ahmadtak-3212/nikolai_project/archive/Server/README.md

# This is the folder for all server related code\
## Server.py
- Main Driver of the server handles databease and web ui requests
