ahmadtak-3212/nikolai_project/mechanical/cad/Parts/Hand/Hand_Reference_Top.jpg

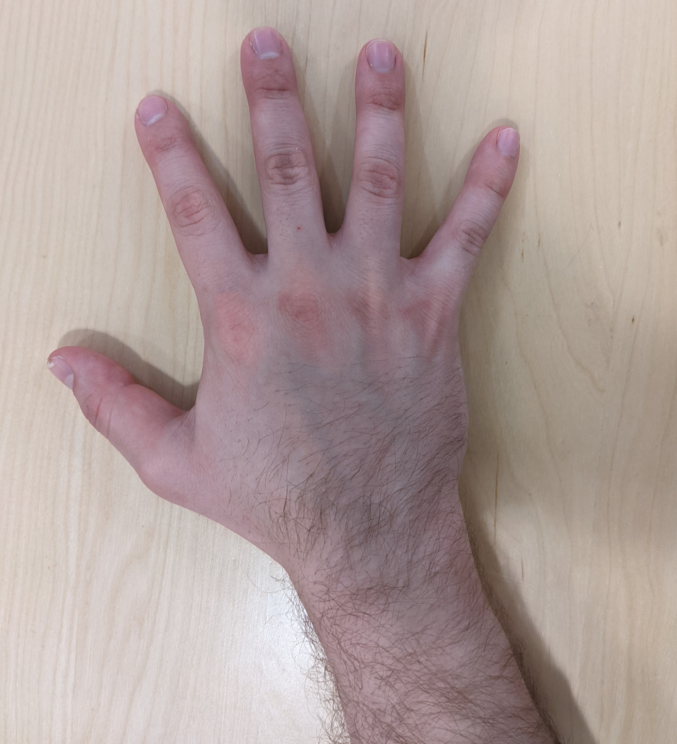
mechanical/cad/Parts/Hand/Hand_Reference_Top.jpg
