ahmadtak-3212/nikolai_project/mechanical/cad/Nikolai.SLDASM

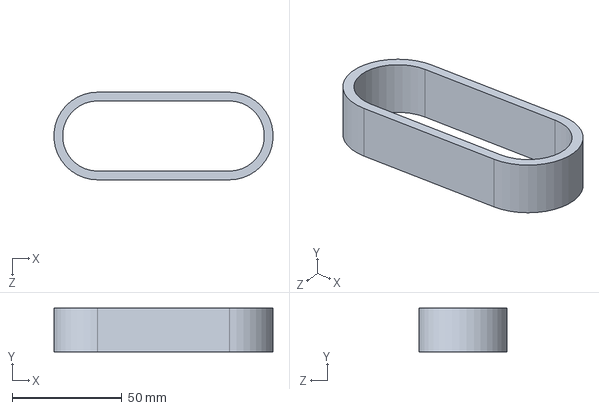
[picture p11: CAD file, 2022-06-26]
mechanical/cad/Nikolai.SLDASM
99.9 x 20.0 x 40.0 mm
