ahmadtak-3212/nikolai_project/mechanical/cad/Parts/Coil/Coil.SLDASM

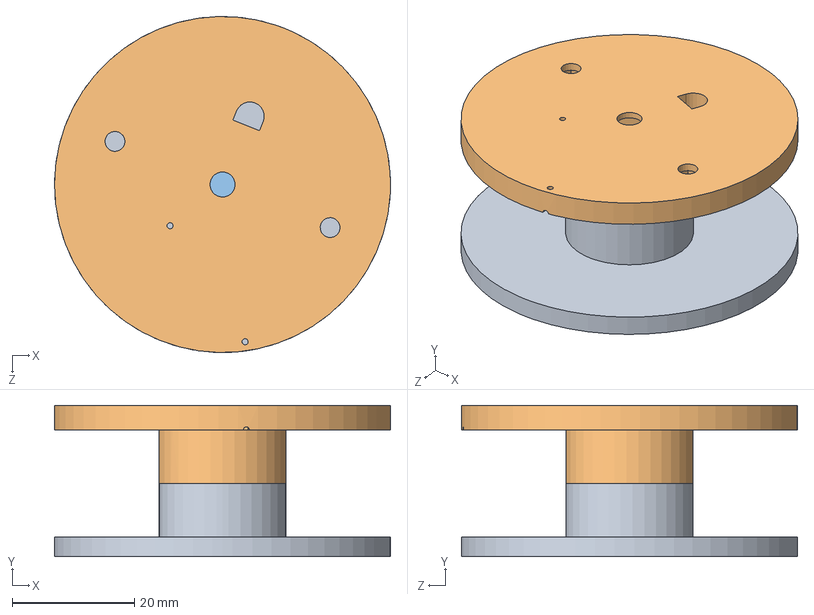
[picture p12: CAD file, 2022-06-26]
mechanical/cad/Parts/Coil/Coil.SLDASM
55.0 x 24.8 x 55.0 mm
Coil_Male
Coil_Female
