ahmadtak-3212/nikolai_project/mechanical/cad/Parts/Hand/Hand.SLDASM

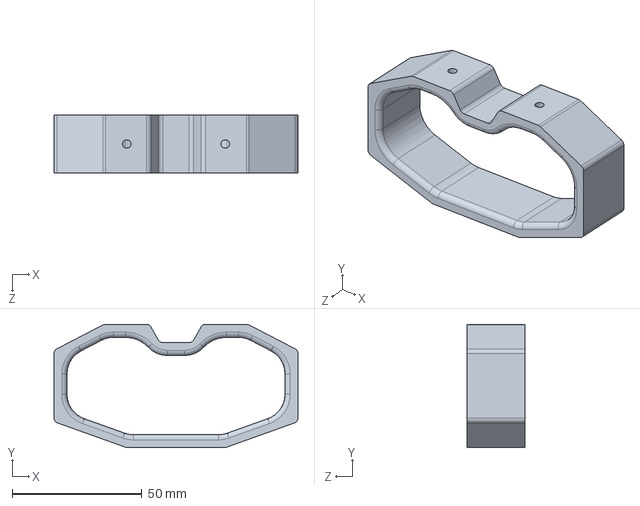
[picture p13: CAD file, 2022-06-26]
mechanical/cad/Parts/Hand/Hand.SLDASM
94.0 x 47.5 x 22.5 mm
