ahmadtak-3212/nikolai_project/mechanical/cad/Parts/Forearm/wrist_pcb.SLDASM

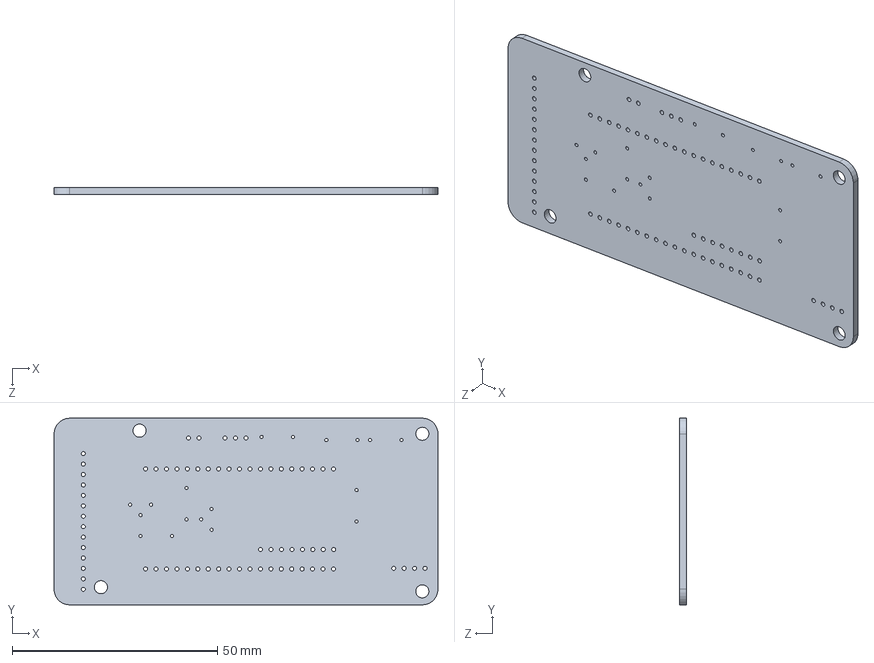
[picture p14: CAD file, 2022-06-26]
mechanical/cad/Parts/Forearm/wrist_pcb.SLDASM
93.5 x 45.5 x 1.60 mm
