ahmadtak-3212/nikolai_project/mechanical/cad/Parts/Coil/Coil_mount.SLDPRT

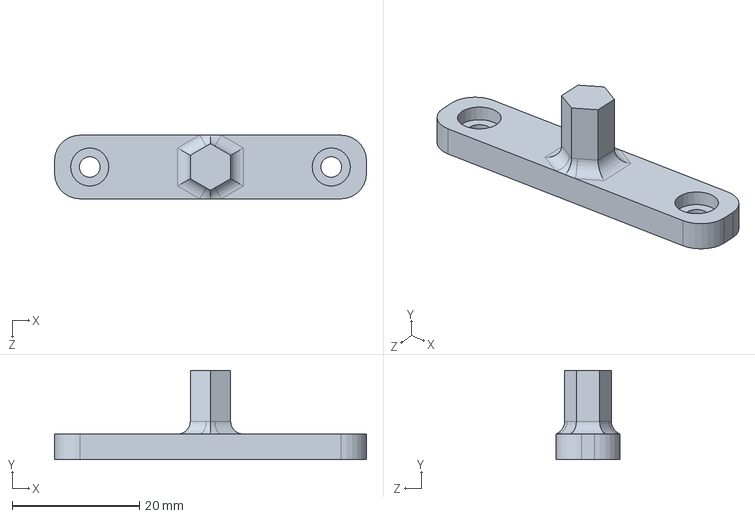
[picture p15: CAD file, 2022-06-26]
mechanical/cad/Parts/Coil/Coil_mount.SLDPRT
49.0 x 14.0 x 10.0 mm
