ahmadtak-3212/nikolai_project/mechanical/cad/Parts/Forearm/Top_Forearm.SLDPRT

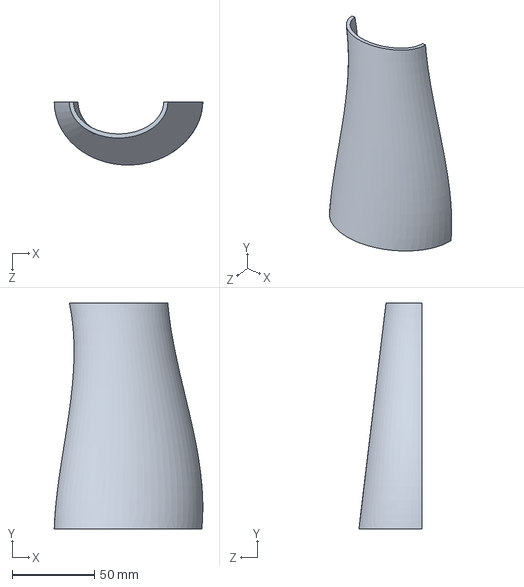
[picture p16: CAD file, 2022-06-26]
mechanical/cad/Parts/Forearm/Top_Forearm.SLDPRT
90.6 x 137.7 x 38.5 mm
