ahmadtak-3212/nikolai_project/mechanical/cam/UMS3_Forearm.3mf

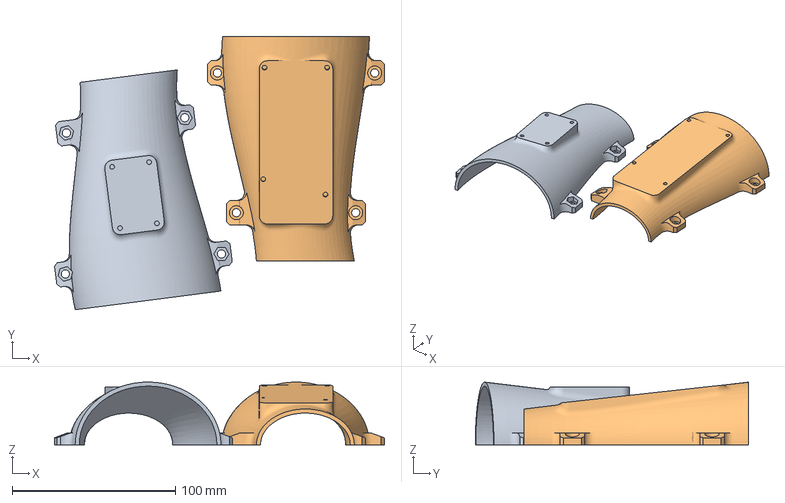
[picture p17: CAD file, 2022-06-26]
mechanical/cam/UMS3_Forearm.3mf
202.1 x 167.5 x 38.5 mm
Bottom_Cover.STL
Top_Cover.STL
