ahmadtak-3212/nikolai_project/mechanical/exports/stl/Coil/Coil - Coil_Female-1.STL

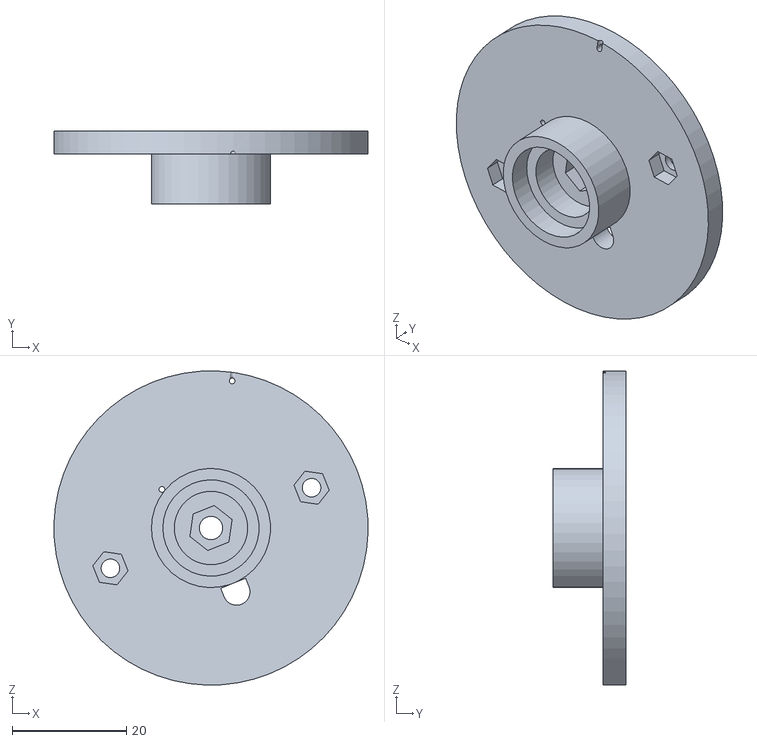
[picture p18: CAD file, 2022-06-26]
mechanical/exports/stl/Coil/Coil - Coil_Female-1.STL
55.0 x 12.8 x 55.0
