ahmadtak-3212/nikolai_project/mechanical/exports/stl/Hand/Hand  - Hand_Mount-1.STL

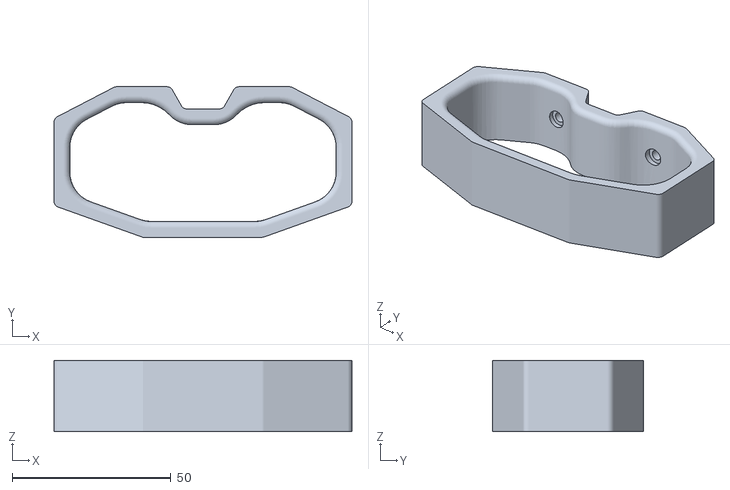
[picture p19: CAD file, 2022-06-26]
mechanical/exports/stl/Hand/Hand - Hand_Mount-1.STL
94.0 x 47.5 x 22.5
