ahmadtak-3212/nikolai_project/mechanical/cad/Parts/Forearm/Bottom_Cover.SLDPRT

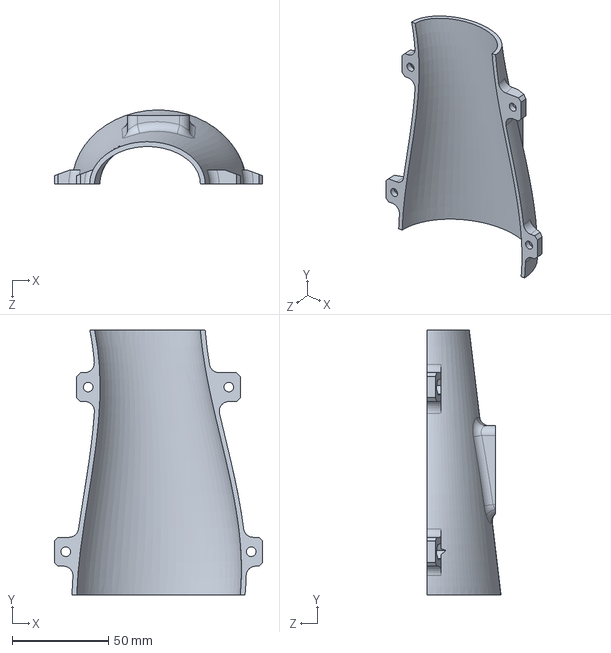
[picture p20: CAD file, 2022-06-26]
mechanical/cad/Parts/Forearm/Bottom_Cover.SLDPRT
108.4 x 137.7 x 38.5 mm
