ahmadtak-3212/nikolai_project/mechanical/exports/stl/Coil/Coil - Coil_Male-1.STL

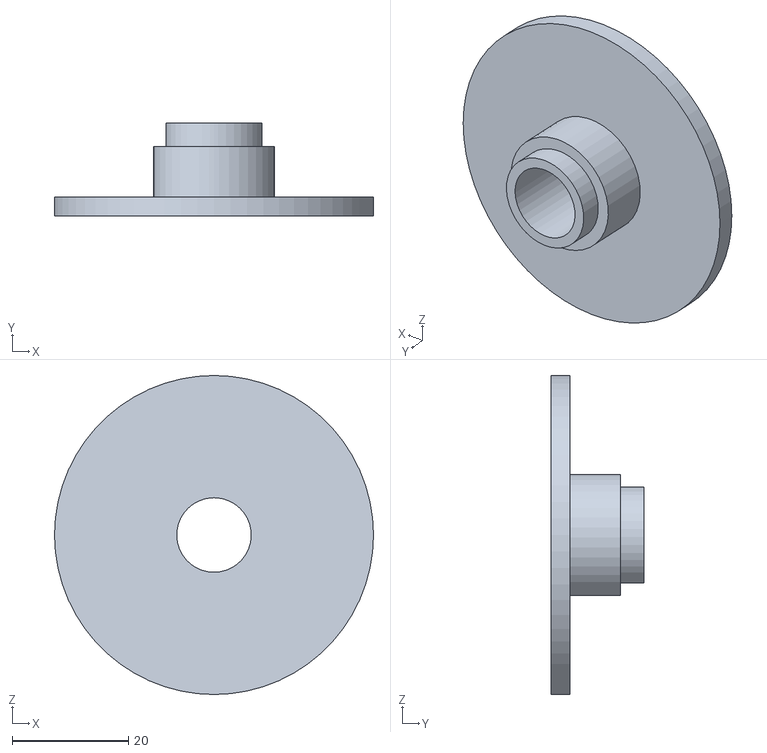
[picture p21: CAD file, 2022-06-26]
mechanical/exports/stl/Coil/Coil - Coil_Male-1.STL
55.0 x 16.0 x 55.0
