ahmadtak-3212/nikolai_project/mechanical/cad/Parts/Forearm/Forearm_Reference.SLDPRT

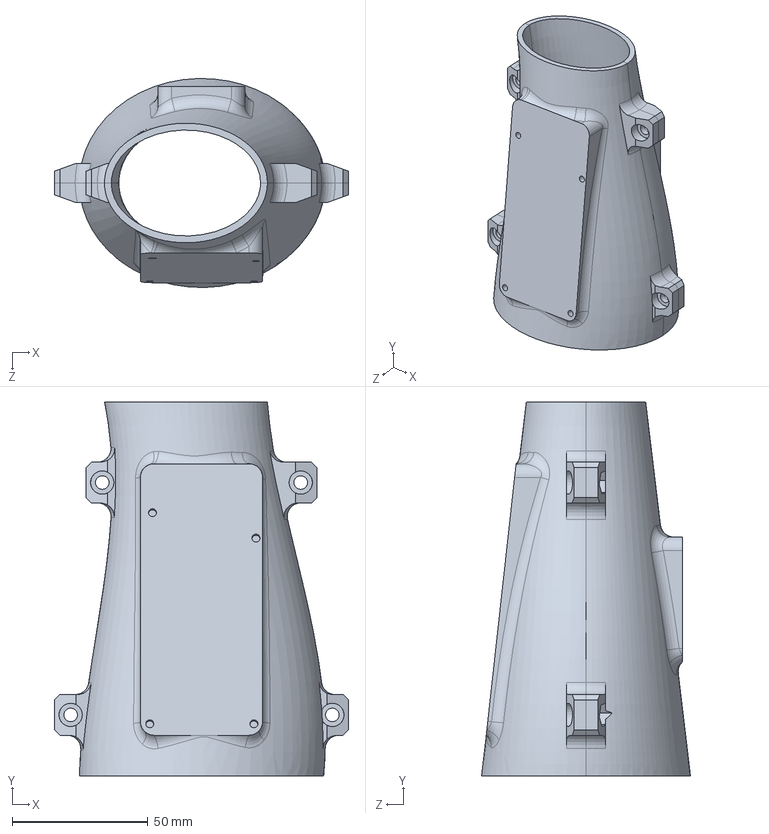
[picture p22: CAD file, 2022-06-26]
mechanical/cad/Parts/Forearm/Forearm_Reference.SLDPRT
108.4 x 137.7 x 77.0 mm
