ahmadtak-3212/nikolai_project/mechanical/cad/Parts/Hand/Hand_Mount.SLDPRT

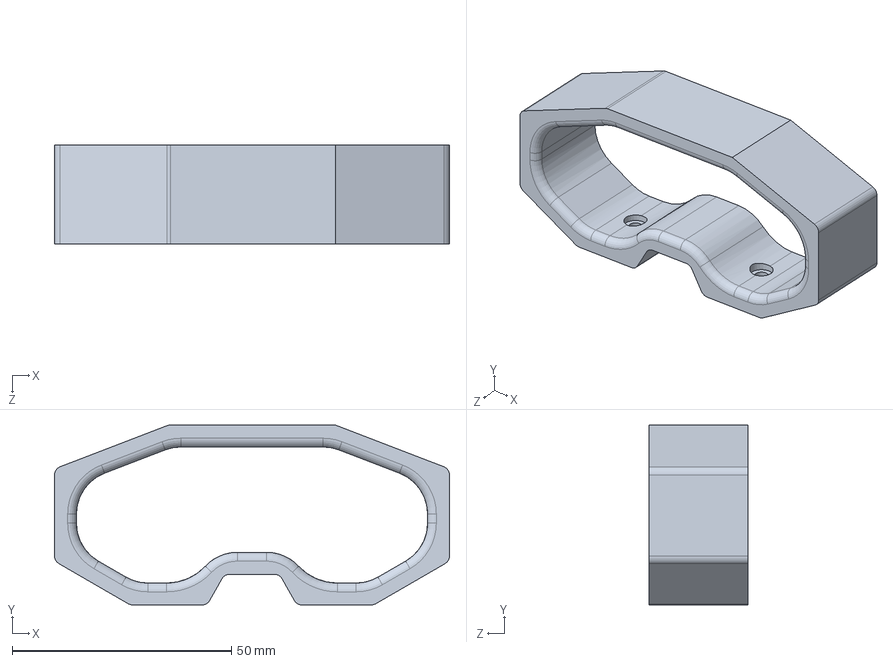
[picture p23: CAD file, 2022-06-26]
mechanical/cad/Parts/Hand/Hand_Mount.SLDPRT
90.0 x 41.0 x 22.5 mm
