ahmadtak-3212/nikolai_project/mechanical/cam/UMS3_Coil.3mf

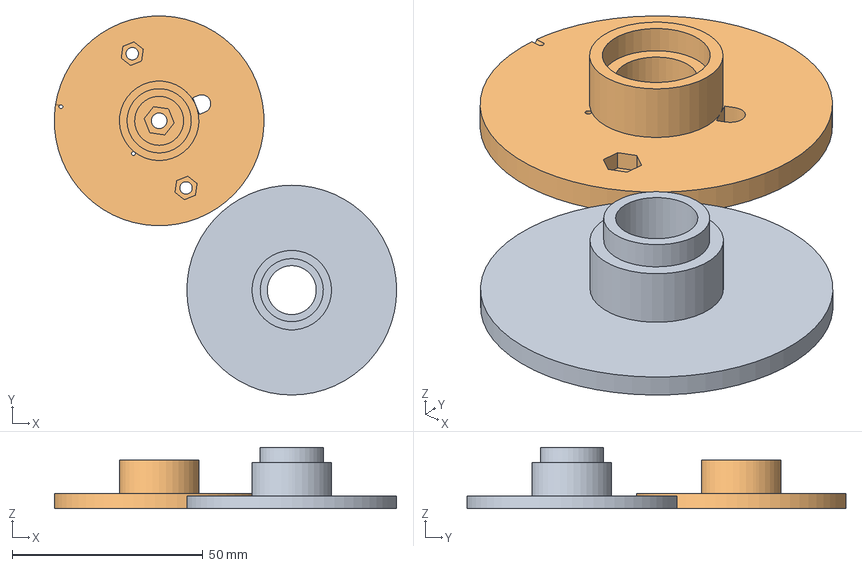
[picture p24: CAD file, 2022-06-26]
mechanical/cam/UMS3_Coil.3mf
89.8 x 99.4 x 16.0 mm
Coil - Coil_Male-1.STL
Coil - Coil_Female-1.STL
