ahmadtak-3212/nikolai_project/mechanical/cad/Parts/Coil/Coil_Winding.SLDPRT

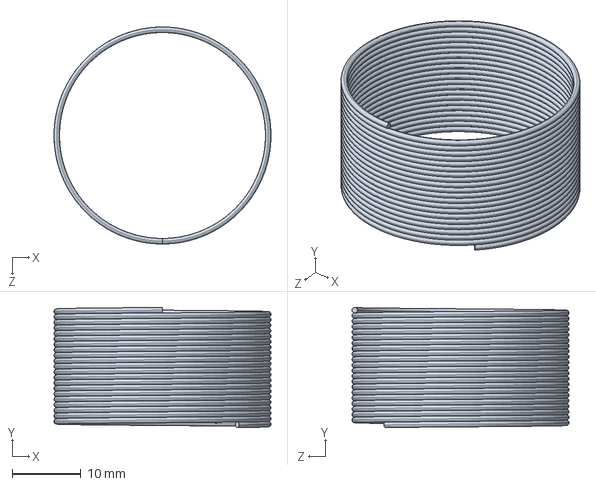
[picture p25: CAD file, 2022-06-26]
mechanical/cad/Parts/Coil/Coil_Winding.SLDPRT
31.6 x 17.5 x 31.6 mm
