ahmadtak-3212/nikolai_project/mechanical/cad/Parts/Coil/Coil_Male.SLDPRT

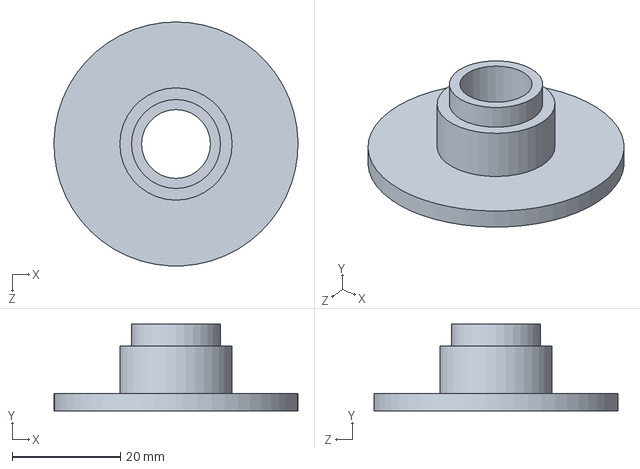
[picture p26: CAD file, 2022-06-26]
mechanical/cad/Parts/Coil/Coil_Male.SLDPRT
45.0 x 16.0 x 45.0 mm
