ahmadtak-3212/nikolai_project/mechanical/cad/Parts/Coil/Core.SLDPRT

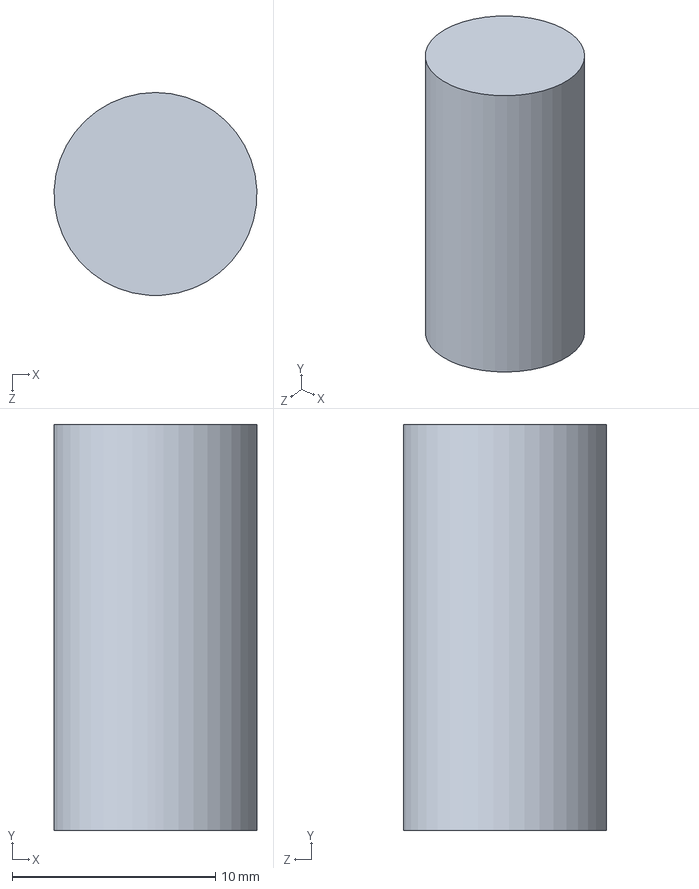
[picture p27: CAD file, 2022-06-26]
mechanical/cad/Parts/Coil/Core.SLDPRT
9.99 x 20.0 x 10.0 mm
