ahmadtak-3212/nikolai_project/(list of files, cad)

Other CAD files:
electrical/wrist_pcb_v1/wrist_pcb.step
mechanical/cad/Parts/Hand/Hand_Reference.SLDPRT
mechanical/exports/stl/Coil_mount.STL
mechanical/cam/UMS3_Hand.3mf
mechanical/cad/Parts/Coil/Coil_Female.SLDPRT
mechanical/cad/Parts/Forearm/Bottom_Forearm.SLDPRT
mechanical/cad/Parts/Forearm/Top_Cover.SLDPRT
mechanical/exports/stl/Forearm/Bottom_Cover.STL
mechanical/exports/stl/Forearm/Top_Cover.STL
