ahmadtak-3212/nikolai_project/electrical/coil_driver_v1/todo.txt

make min spacing 33 mil so it can mill faster. 
mounting holes.
