ahmadtak-3212/nikolai_project/electrical/Nikolai_Schematic.pdf

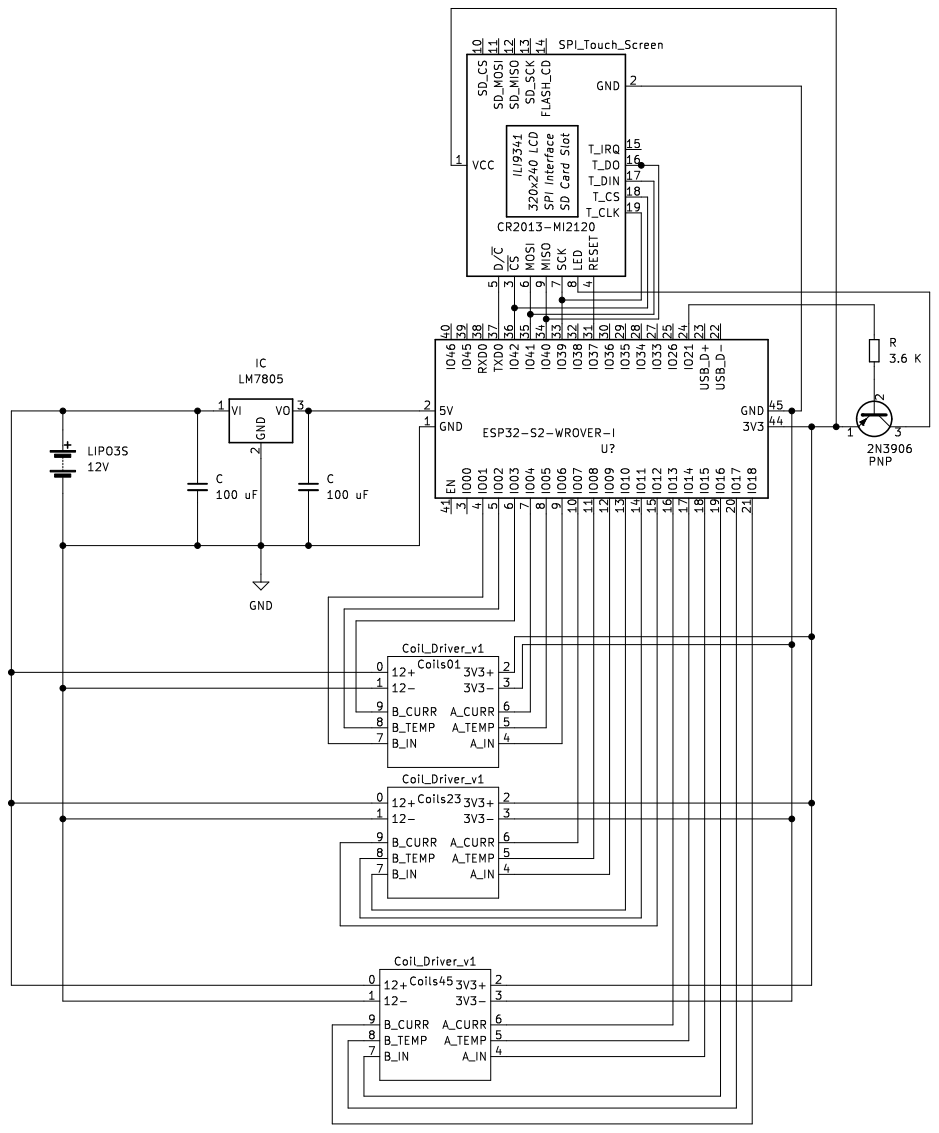
[picture p28: page 1]
