ahmadtak-3212/nikolai_project/electrical/Coil_Driver.pdf

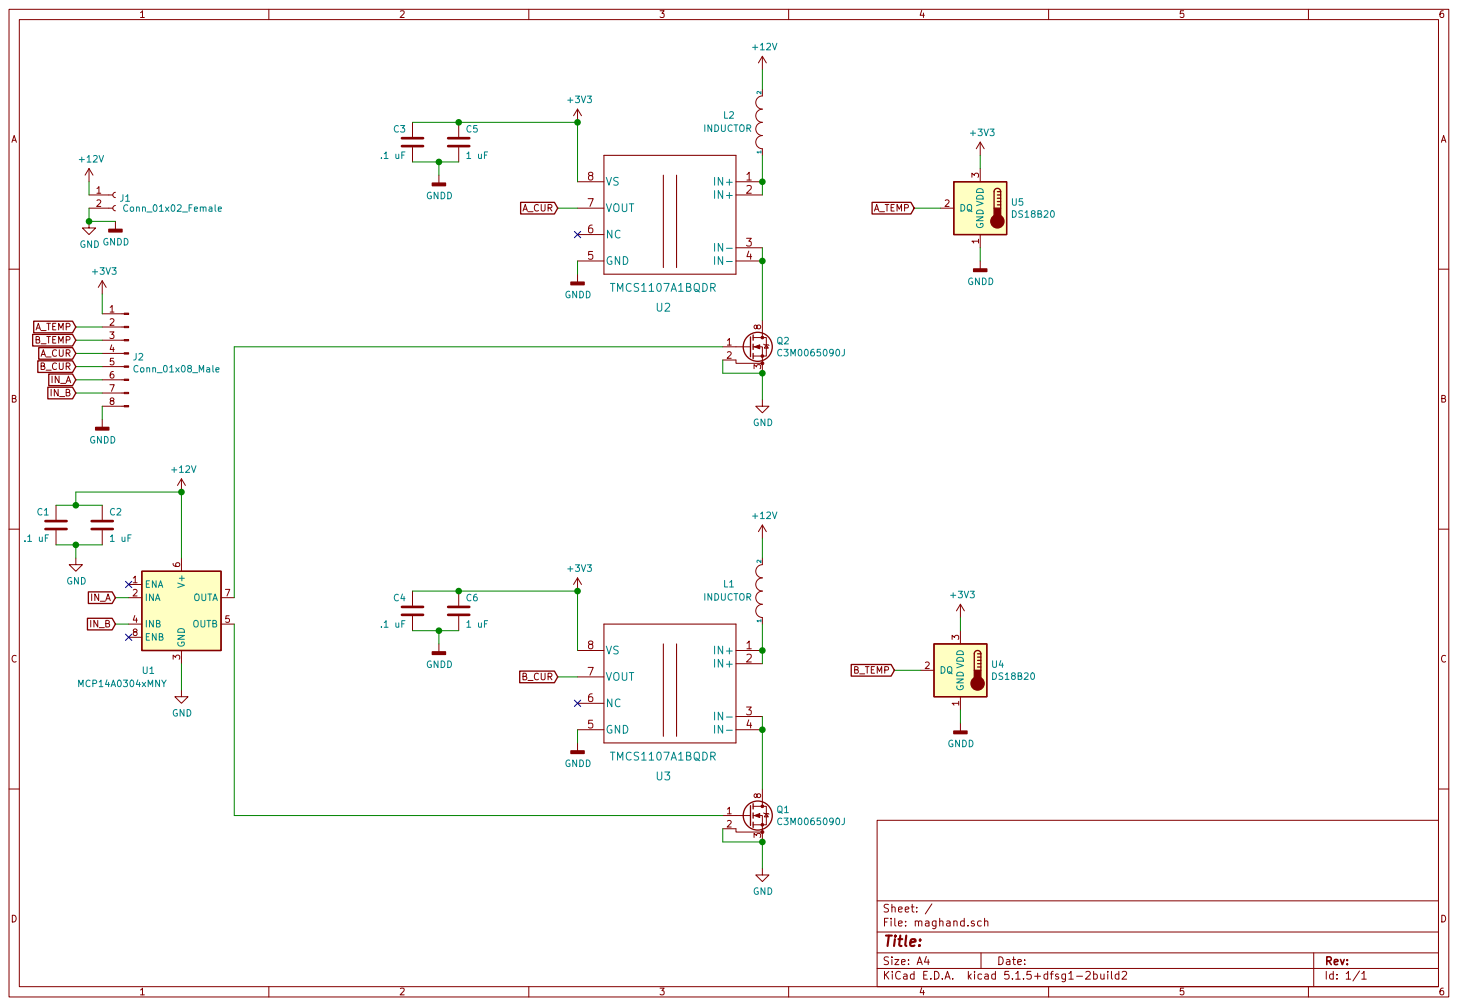
[picture p29: page 1]

File: maghand.sch Sheet: /
