ahmadtak-3212/nikolai_project/electrical/coil_driver_v1/maghand.kicad_pcb

## KiCad design electrical/coil_driver_v1/maghand.kicad_pcb (2026-09-30, an earlier design)

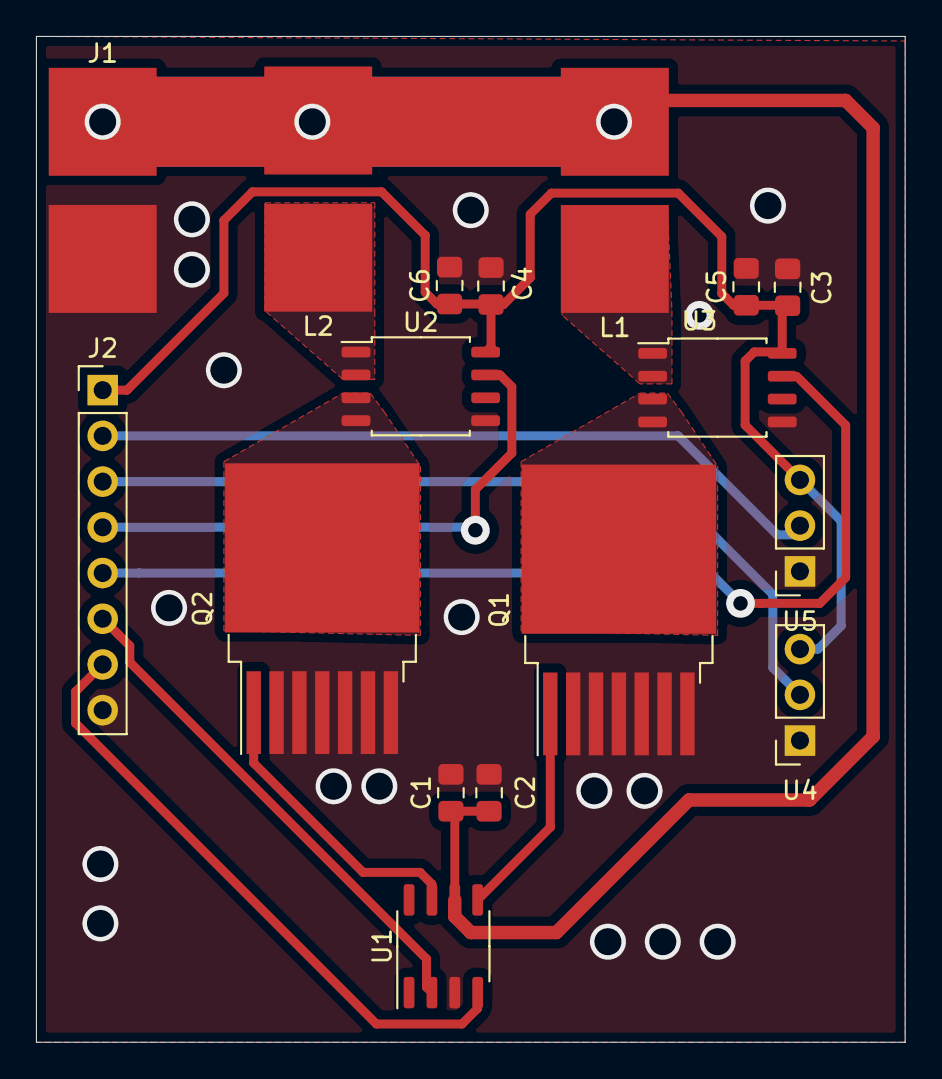
[picture p30: board electrical/coil_driver_v1/maghand.kicad_pcb from above]

Board: 2 copper layers, 48.3 x 55.9 mm, 17 parts (0 on the bottom side), 15 nets.

Parts:
C1, C3, C4: .1 uF; C_0805_2012Metric_Pad1.15x1.40mm_HandSolder
C2, C5, C6: 1 uF; C_0805_2012Metric_Pad1.15x1.40mm_HandSolder
J1: Conn_01x02_Female; 2x6mmsquare
J2: Conn_01x08_Male; PinHeader_1x08_P2.54mm_Vertical
L1, L2: INDUCTOR; 2x6mmsquare
Q1, Q2: C3M0065090J; TO-263-7_TabPin8
U1: MCP14A0304xMNY; SO-8_3.9x4.9mm_P1.27mm
U2, U3: TMCS1107A1BQDR; SOIC-8_5.23x5.23mm_P1.27mm
U4, U5: DS18B20; PinSocket_1x03_P2.54mm_Vertical

Connections:
+3V3: C3.1, C4.1, C5.1, C6.1, J2.1, U2.8, U3.8, U4.3, U5.3
+12V: C1.1, C2.1, J1.1, L1.2, L2.2, U1.6
A_CUR: J2.4, U2.7
A_TEMP: J2.2, U5.2
B_CUR: J2.5, U3.7
B_TEMP: J2.3, U4.2
GND: C1.2, C2.2, C3.2, C4.2, C5.2, C6.2, J1.2, J2.8, Q1.2, Q1.3, Q1.4, Q1.5, Q1.6, Q1.7, Q2.2, Q2.3, Q2.4, Q2.5, Q2.6, Q2.7, U1.3, U2.5, U3.5, U4.1, U5.1
IN_A: J2.6, U1.2
IN_B: J2.7, U1.4
unnamed: L1.1, U3.1, U3.2
unnamed: L2.1, U2.1, U2.2
unnamed: Q1.1, U1.5
unnamed: Q1.8, U3.3, U3.4
unnamed: Q2.1, U1.7
unnamed: Q2.8, U2.3, U2.4
