ahmadtak-3212/nikolai_project/electrical/wrist_pcb_v1/wrist_pcb.kicad_pcb

## KiCad design electrical/wrist_pcb_v1/wrist_pcb.kicad_pcb (2026-09-30)

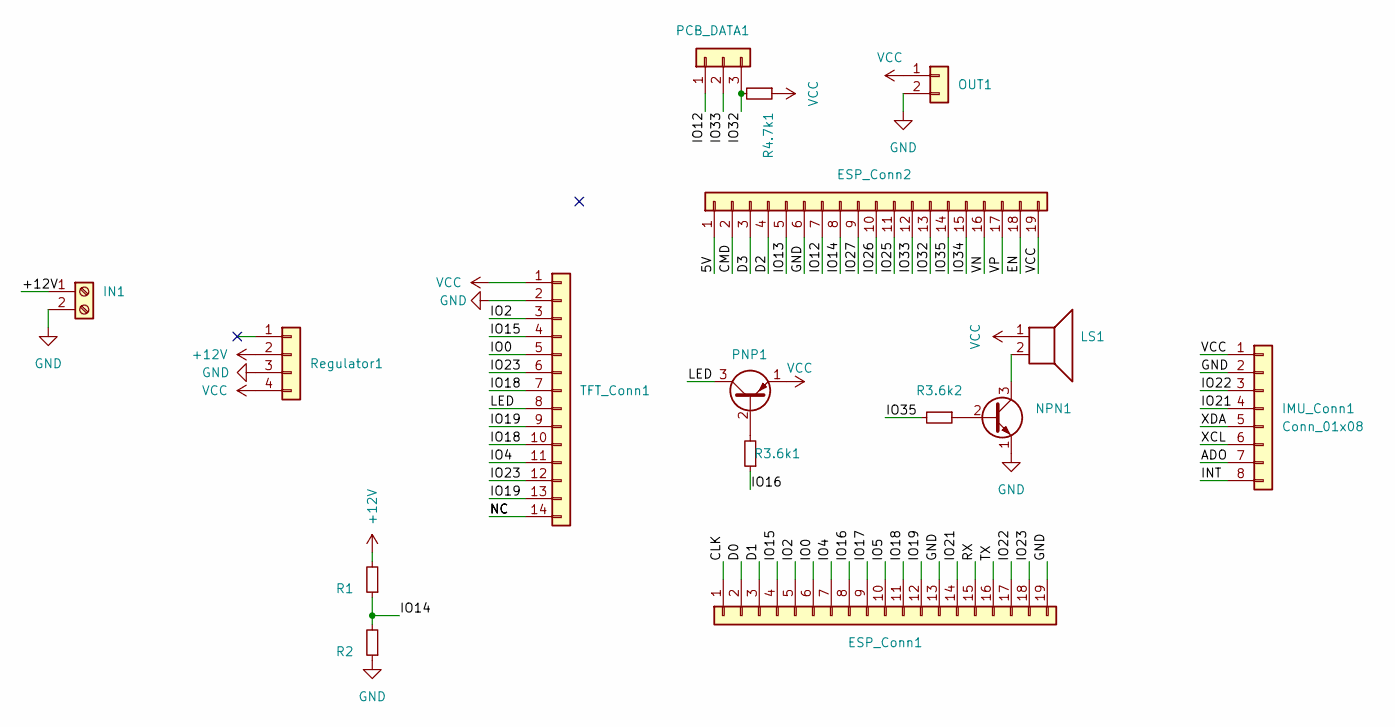
[picture p31: schematic wrist_pcb.kicad_sch]

Parts:
ESP_Conn1, ESP_Conn2: Conn_01x19; PinSocket_1x19_P2.54mm_Vertical
IMU_Conn1: Conn_01x08; PinSocket_1x08_P2.54mm_Vertical
IN1: Screw_Terminal_01x02; TerminalBlock_bornier-2_P5.08mm
LS1: Speaker; R_Axial_DIN0207_L6.3mm_D2.5mm_P7.62mm_Horizontal
NPN1: (no value)
OUT1: Conn_01x02; PinHeader_1x02_P2.54mm_Horizontal
PCB_DATA1: Conn_01x03; PinHeader_1x03_P2.54mm_Horizontal
PNP1: 2N3906
R1, R2, R3.6k1, R3.6k2, R4.7k1: R_Small; R_Axial_DIN0207_L6.3mm_D2.5mm_P7.62mm_Horizontal
Regulator1: Conn_01x04; PinSocket_1x04_P2.54mm_Vertical
TFT_Conn1: Conn_01x14; PinSocket_1x14_P2.54mm_Vertical

Connections:
+12V: IN1.1, R1.2, Regulator1.2
/5V: ESP_Conn2.1
/ADO: IMU_Conn1.7
/CLK: ESP_Conn1.1
/CMD: ESP_Conn2.2
/D0: ESP_Conn1.2
/D1: ESP_Conn1.3
/D2: ESP_Conn2.4
/D3: ESP_Conn2.3
/EN: ESP_Conn2.18
/INT: IMU_Conn1.8
/IO0: ESP_Conn1.6, TFT_Conn1.5
/IO2: ESP_Conn1.5, TFT_Conn1.3
/IO4: ESP_Conn1.7, TFT_Conn1.11
/IO5: ESP_Conn1.10
/IO12: ESP_Conn2.7, PCB_DATA1.1
/IO13: ESP_Conn2.5
/IO14: ESP_Conn2.8, R1.1, R2.2
/IO15: ESP_Conn1.4, TFT_Conn1.4
/IO16: ESP_Conn1.8, R3.6k1.1
/IO17: ESP_Conn1.9
/IO18: ESP_Conn1.11, TFT_Conn1.7, TFT_Conn1.10
/IO19: ESP_Conn1.12, TFT_Conn1.9, TFT_Conn1.13
/IO21: ESP_Conn1.14, IMU_Conn1.4
/IO22: ESP_Conn1.17, IMU_Conn1.3
/IO23: ESP_Conn1.18, TFT_Conn1.6, TFT_Conn1.12
/IO25: ESP_Conn2.11
/IO26: ESP_Conn2.10
/IO27: ESP_Conn2.9
/IO32: ESP_Conn2.13, PCB_DATA1.3, R4.7k1.2
/IO33: ESP_Conn2.12, PCB_DATA1.2
/IO34: ESP_Conn2.15
/IO35: ESP_Conn2.14, R3.6k2.2
/LED: PNP1.3 (C), TFT_Conn1.8
/NC: TFT_Conn1.14
/RX: ESP_Conn1.15
/TX: ESP_Conn1.16
/VN: ESP_Conn2.16
/VP: ESP_Conn2.17
/XCL: IMU_Conn1.6
/XDA: IMU_Conn1.5
GND: ESP_Conn1.13, ESP_Conn1.19, ESP_Conn2.6, IMU_Conn1.2, IN1.2 (Pin_1), NPN1.1 (E), OUT1.2, R2.1, Regulator1.3, TFT_Conn1.2
unnamed: LS1.2, NPN1.3 (C)
unnamed: NPN1.2 (B), R3.6k2.1
unnamed: PNP1.2 (B), R3.6k1.2
VCC: ESP_Conn2.19, IMU_Conn1.1, LS1.1, OUT1.1, PNP1.1 (E), R4.7k1.1, Regulator1.4, TFT_Conn1.1

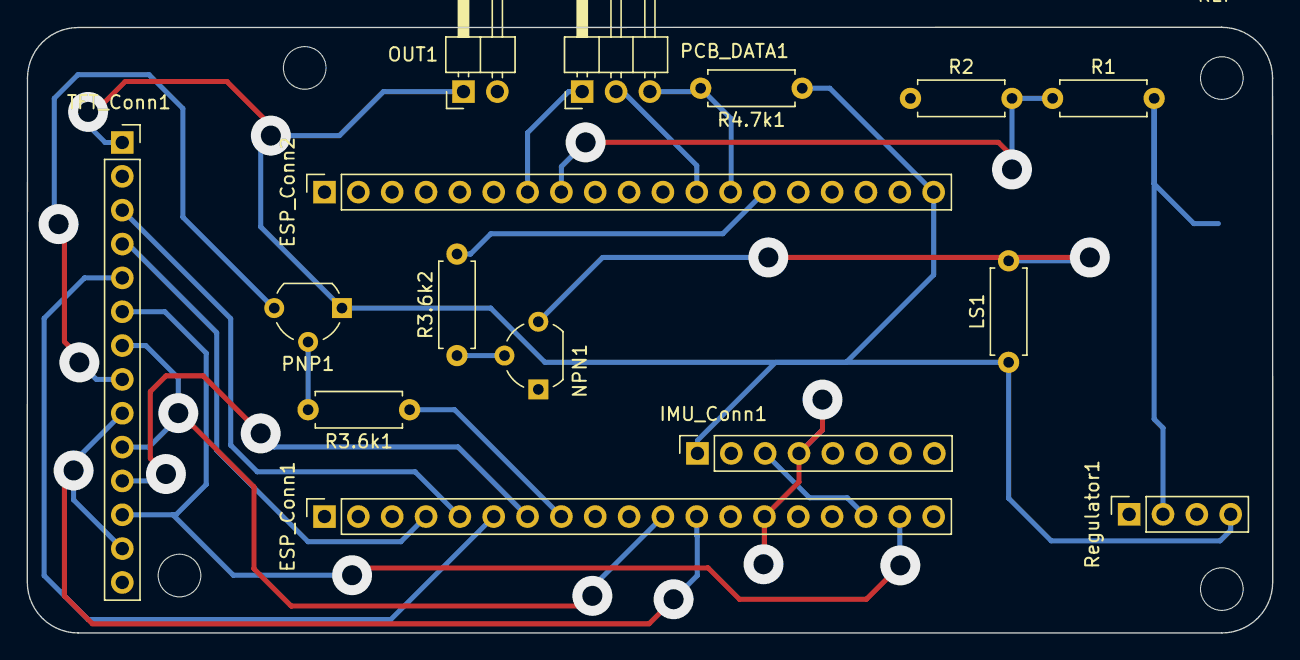
[picture p32: board wrist_pcb.kicad_pcb from above]

Board: 2 copper layers, 93.5 x 45.5 mm, 16 parts (1 on the bottom side), 22 nets.
