ahmadtak-3212/nikolai_project/electrical/coil_driver_v2/maghand.kicad_pcb

## KiCad design electrical/coil_driver_v2/maghand.kicad_pcb (2026-09-30)

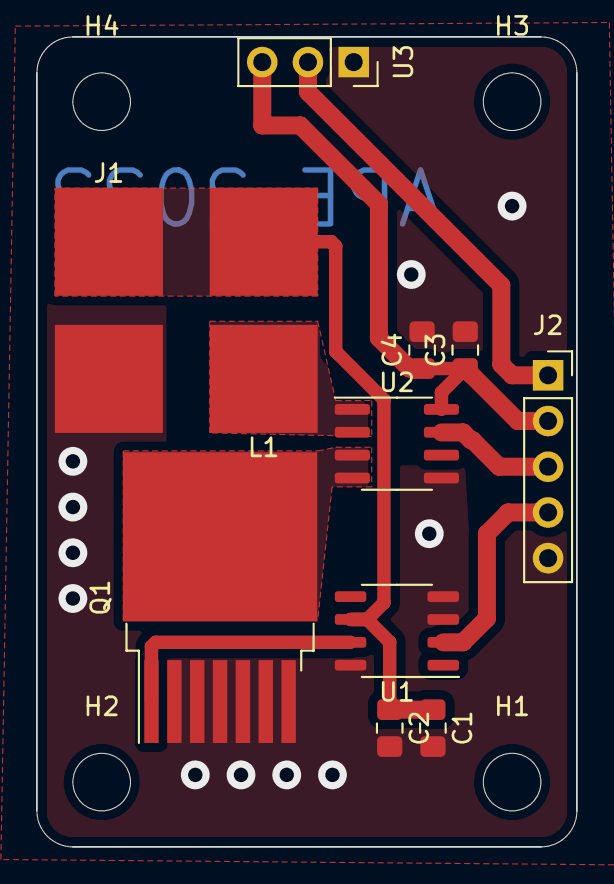
[picture p33: board electrical/coil_driver_v2/maghand.kicad_pcb from above]

Board: 2 copper layers, 30.0 x 45.0 mm, 15 parts (0 on the bottom side), 9 nets.

Parts:
C1, C3: .1 uF; C_0805_2012Metric_Pad1.15x1.40mm_HandSolder
C2, C4: 1 uF; C_0805_2012Metric_Pad1.15x1.40mm_HandSolder
H1, H2, H3, H4: MountingHole_Pad; MountingHole_3.2mm_M3
J1: Conn_01x02_Female; 2x6mmsquare
J2: Conn_01x05_Male; PinSocket_1x05_P2.54mm_Vertical
L1: INDUCTOR; 2x6mmsquare
Q1: C3M0065090J; TO-263-7_TabPin8
U1: MCP14A0304xMNY; SO-8_3.9x4.9mm_P1.27mm
U2: TMCS1107A1BQDR; SOIC-8_3.9x4.9mm_P1.27mm
U3: DS18B20; PinSocket_1x03_P2.54mm_Vertical

Connections:
+3V3: C3.1, C4.1, J2.2, U2.8, U3.3
+12V: C1.1, C2.1, J1.1, L1.2, U1.6
A_CUR: J2.3, U2.7
A_TEMP: J2.1, U3.2
GND: C1.2, C2.2, C3.2, C4.2, J1.2, J2.5, Q1.2, Q1.3, Q1.4, Q1.5, Q1.6, Q1.7, U1.3, U1.4, U1.8, U2.5, U3.1
IN_A: J2.4, U1.2
unnamed: L1.1, U2.1, U2.2
unnamed: Q1.1, U1.7
unnamed: Q1.8, U2.3, U2.4
