ahmadtak-3212/nikolai_project/firmware/Firmware_V2/include/iot_server.h

#include <WiFi.h>
#include <WiFiClientSecure.h>
#include <WiFiClient.h>
#include <ArduinoJson.h>

char network[] = "StataCenter";
char password[] = "";


DynamicJsonDocument doc(1024);
WiFiClientSecure client;   //global WiFiClient Secure object use this one for localization

uint32_t posting_timer;
uint8_t channel = 1; //network channel on 2.4 GHz
byte bssid[] = {0x04, 0x95, 0xE6, 0xAE, 0xDB, 0x41}; //6 byte MAC address of AP you're targeting.
#define RESPONSE_TIMEOUT 6000 //ms to wait for response from host
#define POSTING_PERIOD  30000 //ms to wait between posting step
const uint16_t IN_BUFFER_SIZE = 1000; //size of buffer to hold HTTP request
const uint16_t OUT_BUFFER_SIZE = 1000; //size of buffer to hold HTTP response
char request_buffer[IN_BUFFER_SIZE]; //char array buffer to hold HTTP request
char response_buffer[OUT_BUFFER_SIZE]; //char array buffer to hold HTTP response

void initWIFI(char* network, char* password) {
  int n = WiFi.scanNetworks();
  Serial.println("scan done");
  if (n == 0) {
    Serial.println("no networks found");
  } else {
    Serial.print(n);
    Serial.println(" networks found");
    for (int i = 0; i < n; ++i) {
      Serial.printf("%d: %s, Ch:%d (%ddBm) %s ", i + 1, WiFi.SSID(i).c_str(), WiFi.channel(i), WiFi.RSSI(i), WiFi.encryptionType(i) == WIFI_AUTH_OPEN ? "open" : "");
      uint8_t* cc = WiFi.BSSID(i);
      for (int k = 0; k < 6; k++) {
        Serial.print(*cc, HEX);
        if (k != 5) Serial.print(":");
        cc++;
      }
      Serial.println("");
    }
  }
  delay(100); //wait a bit (100 ms)

  //if using regular connection use line below:
  WiFi.begin(network, password);
  //if using channel/mac specification for crowded bands use the following:
  //WiFi.begin(network, password, channel, bssid);


  uint8_t count = 0; //count used for Wifi check times
  Serial.print("Attempting to connect to ");
  Serial.println(network);
  while (WiFi.status() != WL_CONNECTED && count < 12) {
    delay(500);
    Serial.print(".");
    count++;
  }
  delay(2000);
  if (WiFi.isConnected()) { //if we connected then print our IP, Mac, and SSID we're on
    Serial.println("CONNECTED!");
    Serial.println(WiFi.localIP().toString() + " (" + WiFi.macAddress() + ") (" + WiFi.SSID() + ")");
    delay(500);
  } else { //if we failed to connect just Try again.
    Serial.println("Failed to Connect :/  Going to restart");
    Serial.println(WiFi.status());
    ESP.restart(); // restart the ESP (proper way)
  }
  posting_timer = millis();
}

/*----------------------------------
   char_append Function:
   Arguments:
      char* buff: pointer to character array which we will append a
      char c:
      uint16_t buff_size: size of buffer buff

   Return value:
      boolean: True if character appended, False if not appended (indicating buffer full)
*/
uint8_t char_append(char* buff, char c, uint16_t buff_size) {
  int len = strlen(buff);
  if (len > buff_size) return false;
  buff[len] = c;
  buff[len + 1] = '\0';
  return true;
}



/*----------------------------------
 * do_http_request Function:
 * Arguments:
 *    char* host: null-terminated char-array containing host to connect to
 *    char* request: null-terminated char-arry containing properly formatted HTTP request
 *    char* response: char-array used as output for function to contain response
 *    uint16_t response_size: size of response buffer (in bytes)
 *    uint16_t response_timeout: duration we'll wait (in ms) for a response from server
 *    uint8_t serial: used for printing debug information to terminal (true prints, false doesn't)
 * Return value:
 *    void (none)
 */ 
void do_http_request(const char* host, char* request, char* response, uint16_t response_size, uint16_t response_timeout, uint8_t serial) {
  WiFiClient client; //instantiate a client object
  if (client.connect(host, 80)) { //try to connect to host on port 80
    if (serial) Serial.print(request);//Can do one-line if statements in C without curly braces
    client.print(request);
    memset(response, 0, response_size); //Null out (0 is the value of the null terminator '\0') entire buffer
    uint32_t count = millis();
    while (client.connected()) { //while we remain connected read out data coming back
      client.readBytesUntil('\n', response, response_size);
      if (serial) Serial.println(response);
      if (strcmp(response, "\r") == 0) { //found a blank line!
        break;
      }
      memset(response, 0, response_size);
      if (millis() - count > response_timeout) break;
    }
    memset(response, 0, response_size);
    count = millis();
    while (client.available()) { //read out remaining text (body of response)
      char_append(response, client.read(), OUT_BUFFER_SIZE);
    }
    if (serial) Serial.println(response);
    client.stop();
    if (serial) Serial.println("-----------");
  } else {
    if (serial) Serial.println("connection failed :/");
    if (serial) Serial.println("wait 0.5 sec...");
    client.stop();
  }
}
/*----------------------------------
   do_https_request Function. Similar to do_http_request, but supports https requests
   Arguments:
      char* host: null-terminated char-array containing host to connect to
      char* request: null-terminated char-arry containing properly formatted HTTP request
      char* response: char-array used as output for function to contain response
      uint16_t response_size: size of response buffer (in bytes)
      uint16_t response_timeout: duration we'll wait (in ms) for a response from server
      uint8_t serial: used for printing debug information to terminal (true prints, false doesn't)
   Return value:
      void (none)
*/
void do_https_request(char* host, char* request, char* response, uint16_t response_size, uint16_t response_timeout, uint8_t serial, const char* cert) {
  client.setHandshakeTimeout(30);
  client.setCACert(cert); //set cert for https
  if (client.connect(host,443,4000)) { //try to connect to host on port 443
    if (serial) Serial.print(request);//Can do one-line if statements in C without curly braces
    delay(10);
    Serial.println("there");
    client.print(request);
    response[0] = '\0';
    //memset(response, 0, response_size); //Null out (0 is the value of the null terminator '\0') entire buffer
    uint32_t count = millis();
    while (client.connected()) { //while we remain connected read out data coming back
      client.readBytesUntil('\n', response, response_size);
      if (serial) Serial.println(response);
      if (strcmp(response, "\r") == 0) { //found a blank line!
        break;
      }
      memset(response, 0, response_size);
      if (millis() - count > response_timeout) break;
    }
    memset(response, 0, response_size);
    count = millis();
    while (client.available()) { //read out remaining text (body of response)
      char_append(response, client.read(), response_size);
    }
    if (serial) Serial.println(response);
    client.stop();
    if (serial) Serial.println("-----------");
  } else {
    if (serial) Serial.println("connection failed :/");
    if (serial) Serial.println("wait 0.5 sec...");
    client.stop();
  }
}


void post_data(char *username, char *password, float temperature, float current) {
  if(millis() - posting_timer > POSTING_PERIOD){
    posting_timer = millis();
    request_buffer[0] = '\0';
    char body[100]; //for body
    sprintf(body, "Uname=%s&Pass=%s&temperature=%2f&current=%2f", username, password, temperature, current); //generate body, posting temp, humidity to server
    int body_len = strlen(body); //calculate body length (for header reporting)
    sprintf(request_buffer, "POST http://608dev-2.net/sandbox/sc/team73/Server/server.py  HTTP/1.1\r\n");
    strcat(request_buffer, "Host: 608dev-2.net\r\n");
    strcat(request_buffer, "Content-Type: application/x-www-form-urlencoded\r\n");
    sprintf(request_buffer + strlen(request_buffer), "Content-Length: %d\r\n", body_len); //append string formatted to end of request buffer
    strcat(request_buffer, "\r\n"); //new line from header to body
    strcat(request_buffer, body); //body
    strcat(request_buffer, "\r\n"); //new line
    Serial.println("");
    Serial.println(request_buffer);
    do_http_request("608dev-2.net", request_buffer, response_buffer, OUT_BUFFER_SIZE, RESPONSE_TIMEOUT, false);
    Serial.println(response_buffer); //viewable in Serial Terminal
  }
}

void get_user_data(char * username, float* out_curr_thresh, float* out_temp_curr){
    request_buffer[0] = '\0';
    sprintf(request_buffer, "GET http://608dev-2.net/sandbox/sc/team73/Server/server.py?settings=true&Uname=%s  HTTP/1.1\r\n", username);
    strcat(request_buffer, "Host: 608dev-2.net\r\n\r\n");
    Serial.println("");
    Serial.println(request_buffer);
    do_http_request("608dev-2.net", request_buffer, response_buffer, OUT_BUFFER_SIZE, RESPONSE_TIMEOUT, false);
    Serial.println(response_buffer); //viewable in Serial Terminal

    deserializeJson(doc, response_buffer);
    float curr_thresh = doc["curr_thresh"];
    float temp_thresh = doc["temp_thresh"];
    *out_curr_thresh = curr_thresh;
    *out_temp_curr = temp_thresh;
}

void post_user_data(char * username, char * password, float curr_thresh, float temp_thresh){
    request_buffer[0] = '\0';
    char body[100]; //for body
    sprintf(body, "Uname=%s&Pass=%s&curr_thresh=%2f&temp_thresh=%2f", username, password, curr_thresh, temp_thresh); //generate body, posting temp, humidity to server
    int body_len = strlen(body); //calculate body length (for header reporting)
    sprintf(request_buffer, "POST http://608dev-2.net/sandbox/sc/team73/Server/server.py  HTTP/1.1\r\n");
    strcat(request_buffer, "Host: 608dev-2.net\r\n");
    strcat(request_buffer, "Content-Type: application/x-www-form-urlencoded\r\n");
    sprintf(request_buffer + strlen(request_buffer), "Content-Length: %d\r\n", body_len); //append string formatted to end of request buffer
    strcat(request_buffer, "\r\n"); //new line from header to body
    strcat(request_buffer, body); //body
    strcat(request_buffer, "\r\n"); //new line
    Serial.println("");
    Serial.println(request_buffer);
    do_http_request("608dev-2.net", request_buffer, response_buffer, OUT_BUFFER_SIZE, RESPONSE_TIMEOUT, false);
    Serial.println(response_buffer); //viewable in Serial Terminal
}
