ahmadtak-3212/nikolai_project/(commit log)

2026-09-30 Reorganize into standard project layout
    Flatten the repo root (was Nikolai_Project_Repo/) and move content into
    mechanical/, electrical/, firmware/, docs/ per docs/STRUCTURE.md.
    Budget moved to admin/ (git-ignored); deprecated V1 firmware/server in archive/.
    Adds wrist PCB v1 and other files not previously committed.
    Claude-Session: https://claude.ai/code/session_011fcbtq5kvbvgwpsb6ou6yg
    [Bottom_Cover.SLDPRT, Bottom_Cover.STL, Bottom_Forearm.SLDPRT, Coil - Coil_Female-1.STL, Coil - Coil_Male-1.STL, Coil.SLDASM, Coil_Female.SLDPRT, Coil_Male.SLDPRT]
2026-09-30 Rewrite README with build, reproduction and design details; add board renders
    Claude-Session: https://claude.ai/code/session_011fcbtQ5KvbvgwPSb6oU6YG
